baschdello/UniSeb32/UniSeb32.kicad_pcb

## KiCad design UniSeb32.kicad_pcb (2026-03-05)

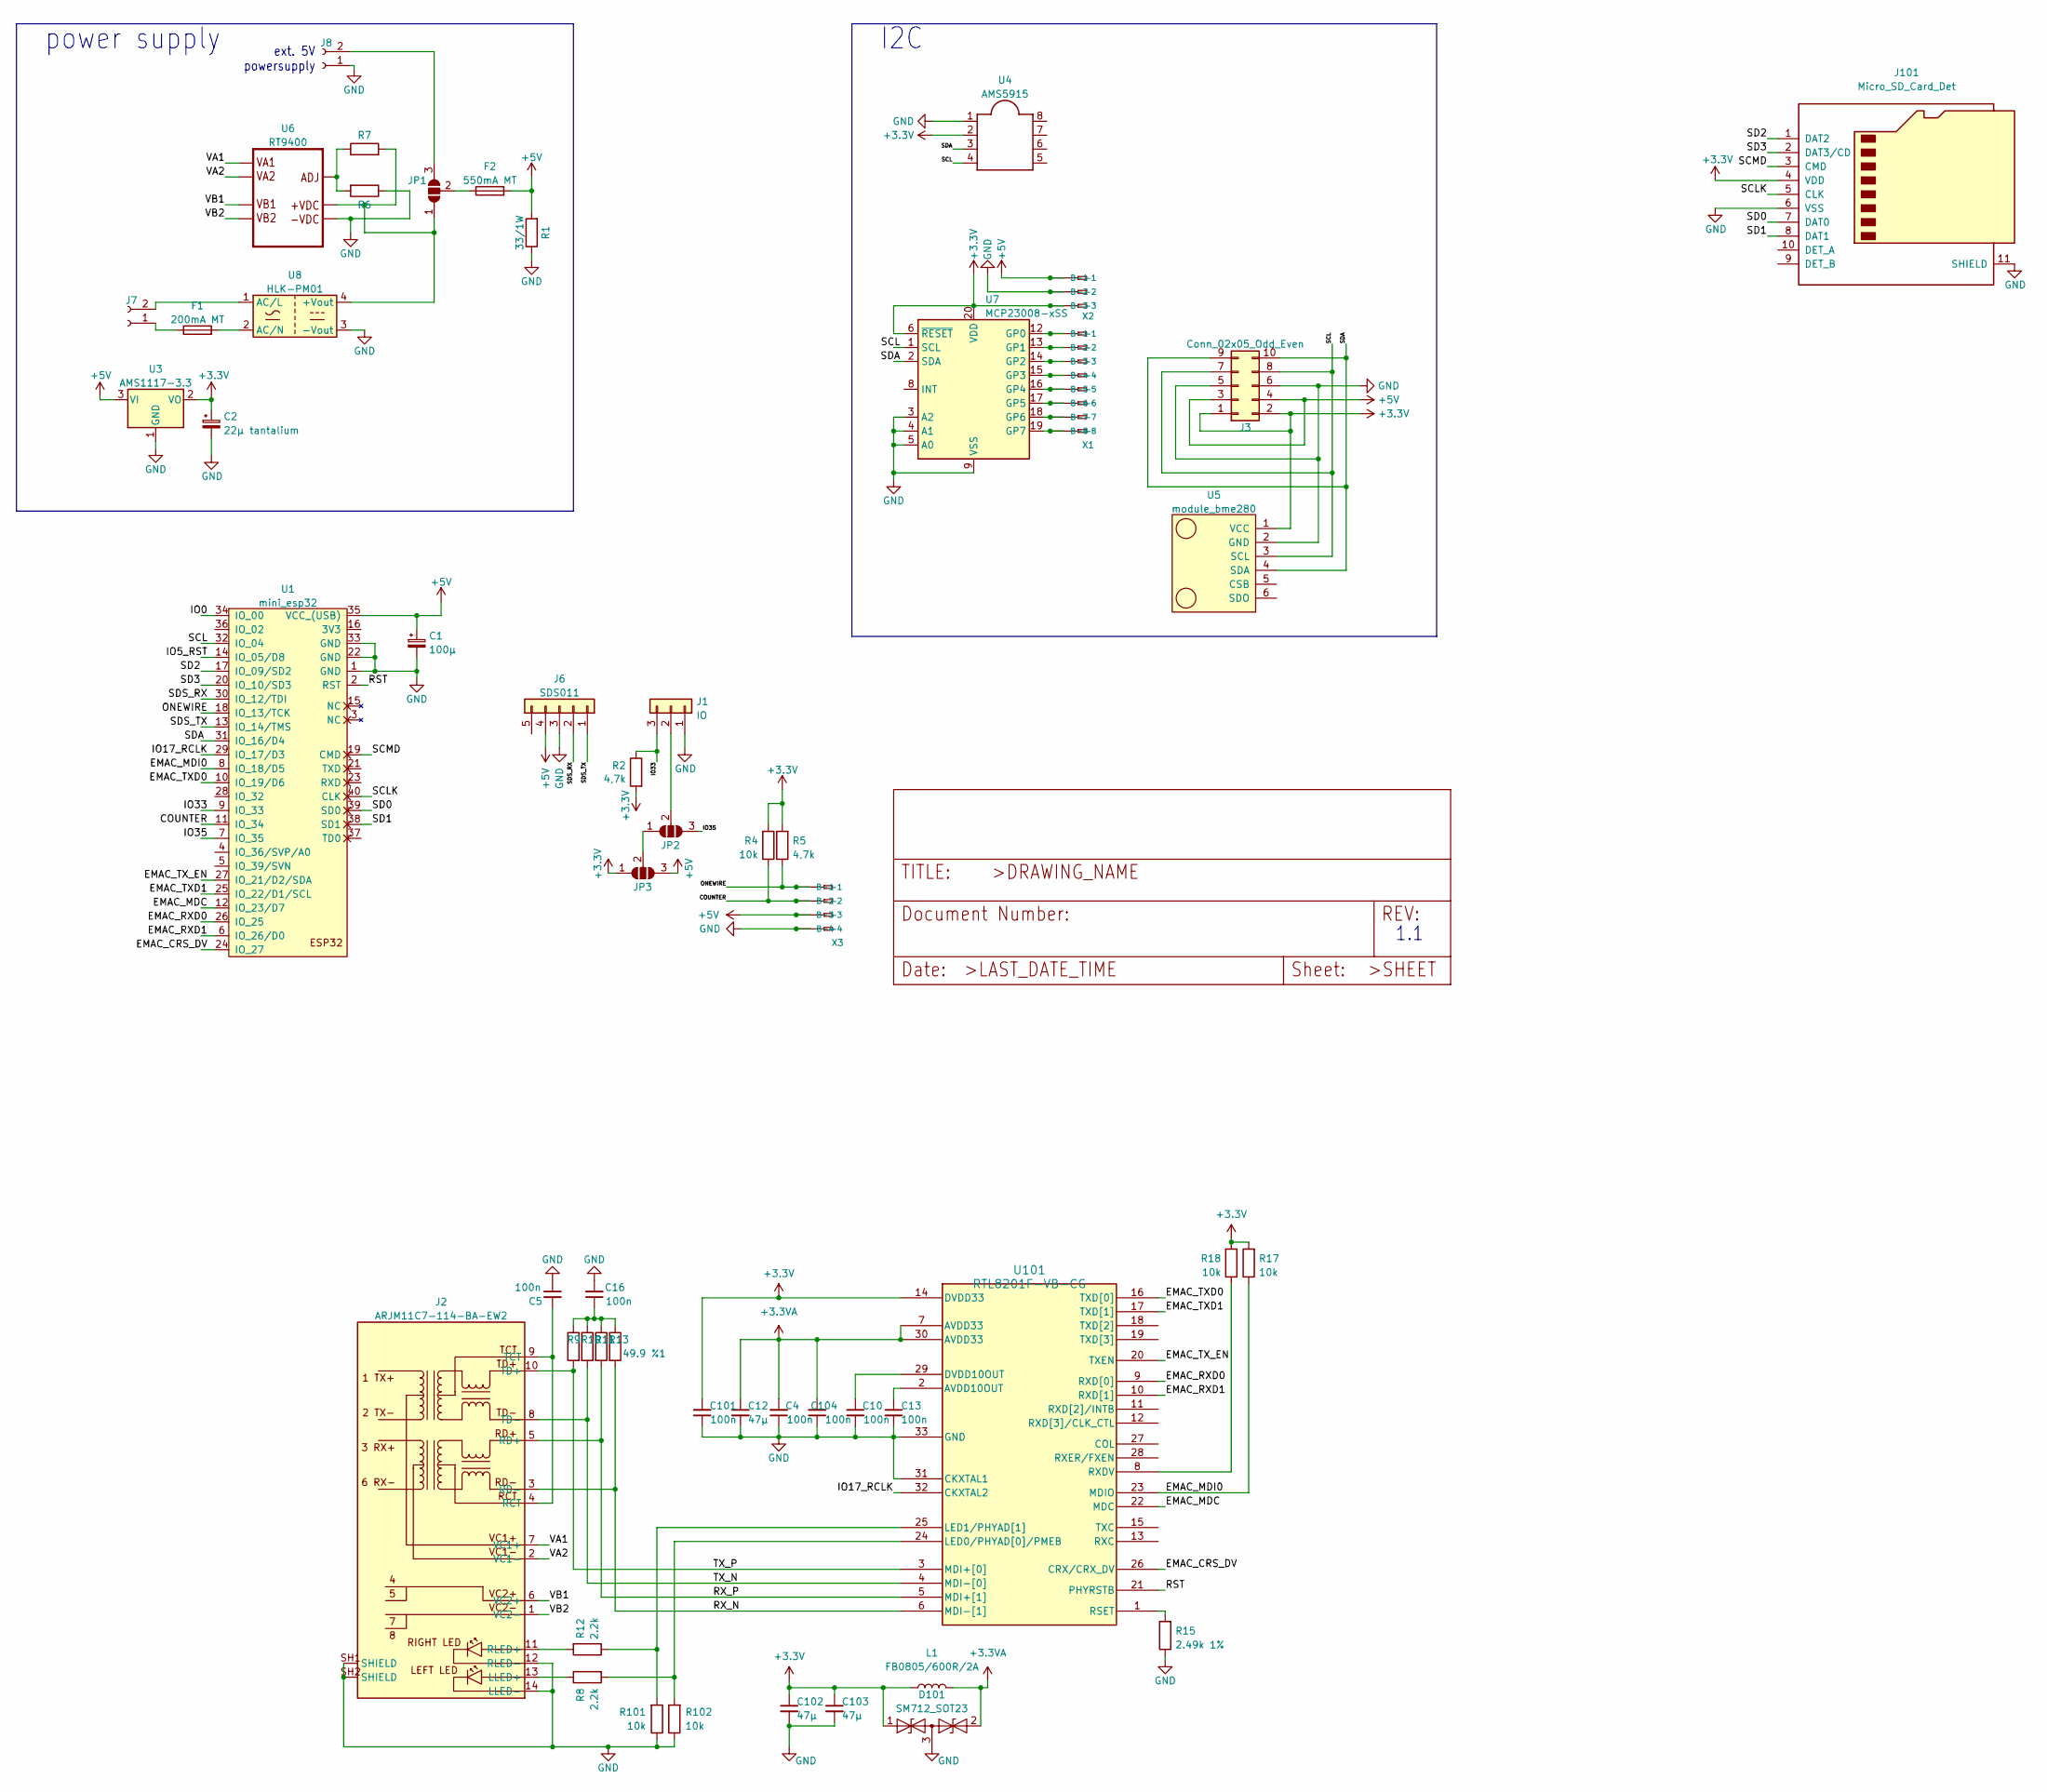
[picture p1: schematic UniSeb32.kicad_sch]

Parts:
C1: 100µ; CP_Radial_D5.0mm_P2.50mm
C2: 22µ tantalium; CP_Radial_D5.0mm_P2.50mm
C4, C5, C10, C13, C16, C101, C104: 100n; C_0603_1608Metric; LCSC C14663
C12, C102, C103: 47µ; C_0805_2012Metric; LCSC C2844386
D101: SM712_SOT23; SOT-23; Digikey 1655-S2303CT-ND
F1: 200mA MT; Fuse_Littelfuse_372_D8.50mm
F2: 550mA MT; Fuse_Littelfuse_372_D8.50mm
J1: IO; FanPinHeader_1x03_P2.54mm_Vertical
J2: ARJM11C7-114-BA-EW2
J3: Conn_02x05_Odd_Even; PinHeader_2x05_P2.54mm_Vertical_SMD
J6: SDS011; JST_XH_B5B-XH-A_1x05_P2.50mm_Vertical
J7, J8: Conn_01x02_Female; TerminalBlock_bornier-2_P5.08mm
J101: Micro_SD_Card_Det; microSD_HC_Hirose_DM3D-SF
JP1, JP2, JP3: SolderJumper_3_Open; SolderJumper-3_P1.3mm_Open_Pad1.0x1.5mm_NumberLabels
L1: FB0805/600R/2A; L_0805_2012Metric; LCSC C1017
R1: 33/1W; R_Axial_DIN0414_L11.9mm_D4.5mm_P5.08mm_Vertical
R2, R5: 4,7k; R_0603_1608Metric; LCSC C23162
R4: 10k; R_0603_1608Metric; JLC 0603
R6, R7: R; R_0603_1608Metric
R8, R12: 2.2k; R_0603_1608Metric; LCSC C4190
R9, R10, R11, R13: 49.9 %1; R_0603_1608Metric; LCSC C23185
R15: 2.49k 1%; R_0603_1608Metric; LCSC C203449
R17, R18, R101, R102: 10k; R_0603_1608Metric; LCSC C25804
U1: mini_esp32; ESP32_mini
U3: AMS1117-3.3; SOT-223-3_TabPin2; LCSC C6186
U4: AMS5915
U5: module_bme280
U6: RT9400
U7: MCP23008-xSS; SSOP-20_5.3x7.2mm_P0.65mm
U8: HLK-PM01; Converter_ACDC_HiLink_HLK-PMxx
U101: RTL8201F-VB-CG; QFN_8201F-VB-CG_RTK; LCSC C45044
X1: 233-508; con-wago-233-508
X2: 233-503; con-wago-233-503
X3: 233-504; con-wago-233-504

Connections:
+3.3V: C2.1, C101.2, C102.1, C103.1, D101.1 (A1), J3.1, J3.2, J101.4 (VDD), JP3.1 (A), L1.1, R2.2, R4.2, R5.2, R17.2, R18.2, U3.2 (VO), U4.2 (VCC), U5.1 (VCC), U7.6 (~RESET), U7.20 (VDD), U101.14 (DVDD33), X2.A3 (-3), X2.B3 (B-3)
+3.3VA: C4.2, C12.1, C104.2, D101.2 (A2), L1.2, U101.7 (AVDD33), U101.30 (AVDD33)
+5V: C1.1, F2.2, J3.3, J3.4, J6.4, JP3.3 (B), R1.2, U1.35 (VCC_(USB)), U3.3 (VI), X2.A1 (-1), X2.B1 (B-1), X3.A3 (-3), X3.B3 (B-3)
/COUNTER: R4.1, U1.11 (IO_34), X3.A2 (-2), X3.B2 (B-2)
/EMAC_CRS_DV: U1.24 (IO_27), U101.26 (CRX/CRX_DV)
/EMAC_MDC: U1.12 (IO_23/D7), U101.22 (MDC)
/EMAC_MDI0: R17.1, U1.8 (IO_18/D5), U101.23 (MDIO)
/EMAC_RXD0: U1.26 (IO_25), U101.9 (RXD[0])
/EMAC_RXD1: U1.6 (IO_26/D0), U101.10 (RXD[1])
/EMAC_TXD0: U1.10 (IO_19/D6), U101.16 (TXD[0])
/EMAC_TXD1: U1.25 (IO_22/D1/SCL), U101.17 (TXD[1])
/EMAC_TX_EN: U1.27 (IO_21/D2/SDA), U101.20 (TXEN)
/IO0: U1.34 (IO_00)
/IO5_RST: U1.14 (IO_05/D8)
/IO17_RCLK: U1.29 (IO_17/D3), U101.32 (CKXTAL2)
/IO33: J1.3, R2.1, U1.9 (IO_33)
/IO35: JP2.3 (B), U1.7 (IO_35)
/ONEWIRE: R5.1, U1.18 (IO_13/TCK), X3.A1 (-1), X3.B1 (B-1)
/RST: U1.2 (RST), U101.21 (PHYRSTB)
/RX_N: J2.3 (RD-), R13.2, U101.6 (MDI-[1])
/RX_P: J2.5 (RD+), R11.2, U101.5 (MDI+[1])
/SCL: J3.7, J3.8, U1.32 (IO_04), U4.4 (SCL), U5.3 (SCL), U7.1 (SCL)
/SCLK: J101.5 (CLK), U1.40 (CLK)
/SCMD: J101.3 (CMD), U1.19 (CMD)
/SD0: J101.7 (DAT0), U1.39 (SD0)
/SD1: J101.8 (DAT1), U1.38 (SD1)
/SD2: J101.1 (DAT2), U1.17 (IO_09/SD2)
/SD3: J101.2 (DAT3/CD), U1.20 (IO_10/SD3)
/SDA: J3.9, J3.10, U1.31 (IO_16/D4), U4.3 (SDA), U5.4 (SDA), U7.2 (SDA)
/SDS_RX: J6.2, U1.30 (IO_12/TDI)
/SDS_TX: J6.1, U1.13 (IO_14/TMS)
/TX_N: J2.8 (TD-), R10.2, U101.4 (MDI-[0])
/TX_P: J2.10 (TD+), R9.2, U101.3 (MDI+[0])
/VA1: J2.7 (VC1+), U6.P$1 (VA1)
/VA2: J2.2 (VC1-), U6.P$2 (VA2)
/VB1: J2.6 (VC2+), U6.P$3 (VB1)
/VB2: J2.1 (VC2-), U6.P$4 (VB2)
GND: C1.2, C2.2, C4.1, C5.1, C10.2, C12.2, C13.2, C16.2, C101.1, C102.2, C103.2, C104.1, D101.3 (common), J1.1, J2.12 (RLED-), J2.14 (LLED-), J2.SH1 (SHIELD), J2.SH2 (SHIELD), J3.5, J3.6, J6.3, J8.1, J101.6 (VSS), J101.11 (SHIELD), R1.1, R6.1, R15.1, R101.1, R102.1, U1.1 (GND), U1.22 (GND), U1.33 (GND), U3.1 (GND), U4.1 (GND), U5.2 (GND), U6.P$5 (-VDC), U7.3 (A2), U7.4 (A1), U7.5 (A0), U7.9 (VSS), U8.3 (-Vout), U101.31 (CKXTAL1), U101.33 (GND), X2.A2 (-2), X2.B2 (B-2), X3.A4 (-4), X3.B4 (B-4)
unnamed: C16.1, R9.1, R10.1, R11.1, R13.1
unnamed: J1.2, JP2.2 (C)
unnamed: J2.13 (LLED+), R8.1
unnamed: C5.2, J2.4 (RCT), J2.9 (TCT)
unnamed: J2.11 (RLED+), R12.2
unnamed: F1.1, J7.1
unnamed: J7.2, U8.1 (AC/L)
unnamed: J8.2, JP1.3 (B)
unnamed: JP1.1 (A), R7.2, U6.P$6 (+VDC), U8.4 (+Vout)
unnamed: F2.1, JP1.2 (C)
unnamed: JP2.1 (A), JP3.2 (C)
unnamed: R6.2, R7.1, U6.P$7 (ADJ)
unnamed: U7.12 (GP0), X1.A1 (-1), X1.B1 (B-1)
unnamed: U7.13 (GP1), X1.A2 (-2), X1.B2 (B-2)
unnamed: U7.14 (GP2), X1.A3 (-3), X1.B3 (B-3)
unnamed: U7.15 (GP3), X1.A4 (-4), X1.B4 (B-4)
unnamed: U7.16 (GP4), X1.A5 (-5), X1.B5 (B-5)
unnamed: U7.17 (GP5), X1.A6 (-6), X1.B6 (B-6)
unnamed: U7.18 (GP6), X1.A7 (-7), X1.B7 (B-7)
unnamed: U7.19 (GP7), X1.A8 (-8), X1.B8 (B-8)
unnamed: F1.2, U8.2 (AC/N)
unnamed: C13.1, U101.2 (AVDD10OUT)
unnamed: C10.1, U101.29 (DVDD10OUT)
unnamed: R8.2, R102.2, U101.24 (LED0/PHYAD[0]/PMEB)
unnamed: R12.1, R101.2, U101.25 (LED1/PHYAD[1])
unnamed: R15.2, U101.1 (RSET)
unnamed: R18.1, U101.8 (RXDV)

Notes on the sheet:
I2C
1.1
power supply
ext. 5V powersupply

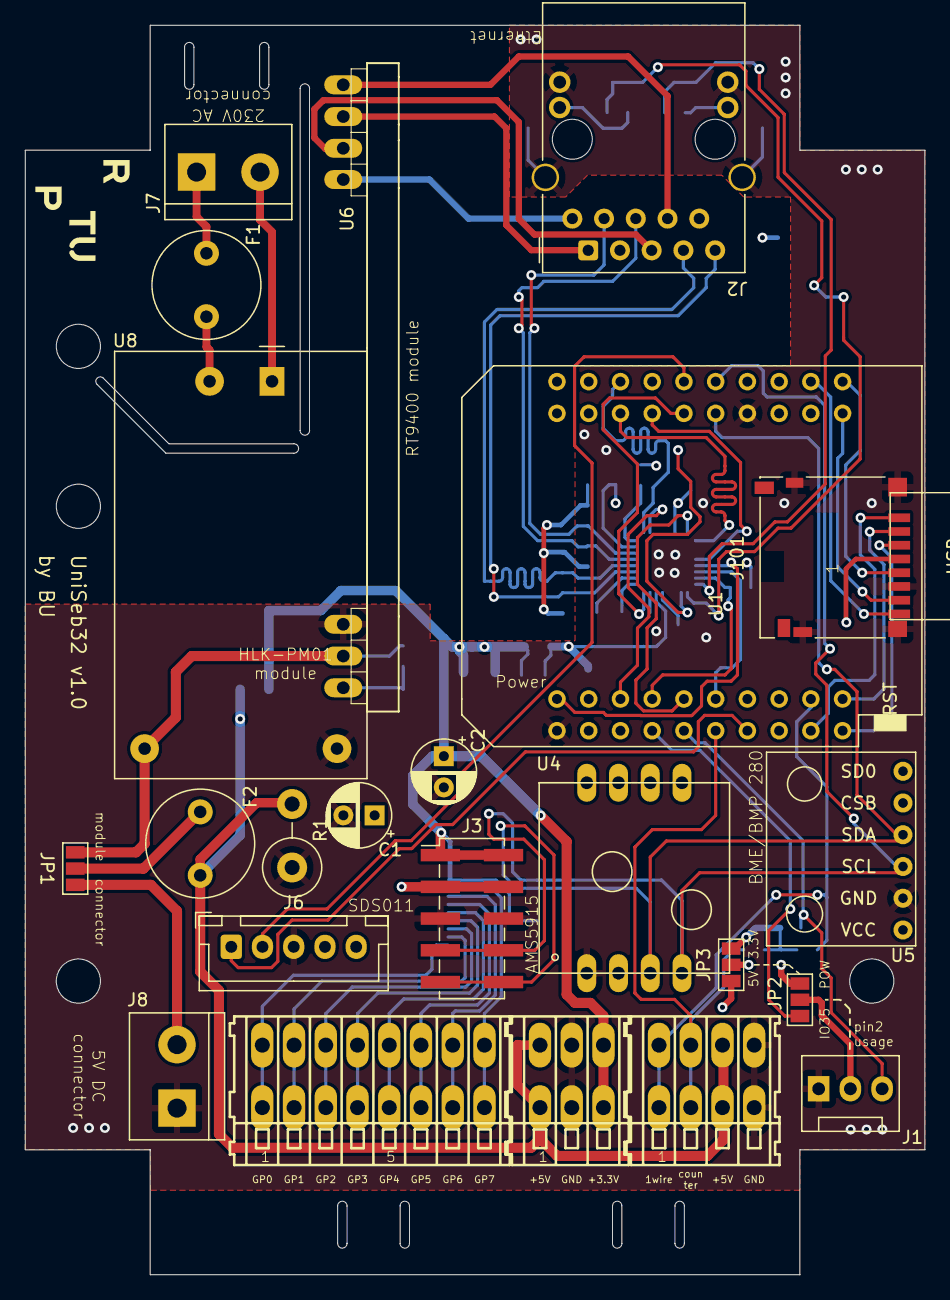
[picture p2: board UniSeb32.kicad_pcb from above]

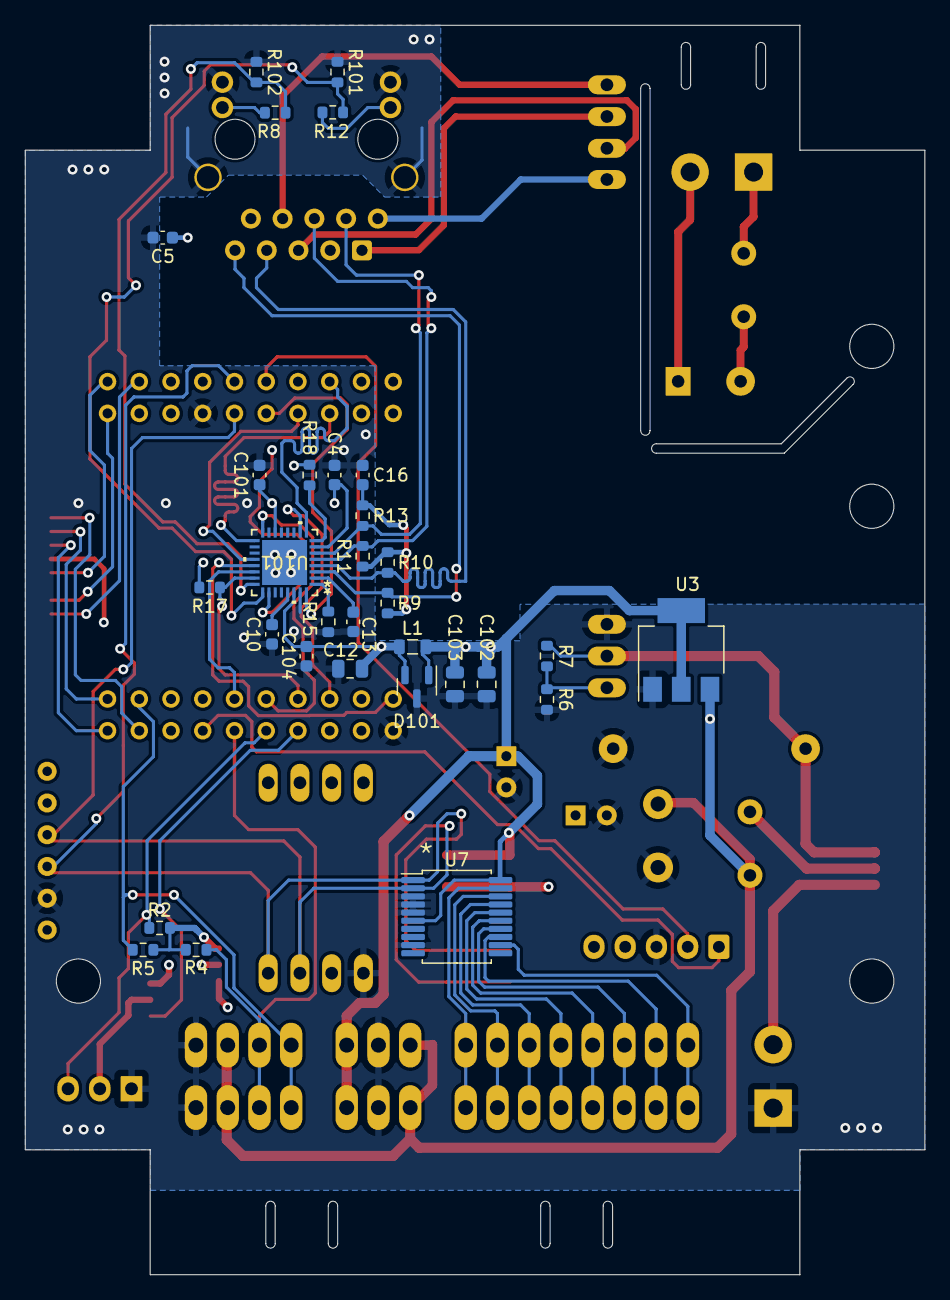
[picture p3: board UniSeb32.kicad_pcb from below]

Board: 4 copper layers, 72.0 x 100.0 mm, 54 parts (31 on the bottom side), 63 nets.
