baschdello/UniSeb32/(commit log)

2023-05-15 switched to 4 layer PCB. Routed remaining airwires
    [UniSeb32.kicad_pcb, UniSeb32.kicad_sch]
2023-08-10 Added attributes for jlcpcb assembly
    [UniSeb32-B_Cu.gbl, UniSeb32-B_Mask.gbs, UniSeb32-B_Paste.gbp, UniSeb32-B_Silkscreen.gbo, UniSeb32-Edge_Cuts.gm1, UniSeb32-F_Cu.gtl, UniSeb32-F_Mask.gts, UniSeb32-F_Paste.gtp]
2023-09-05 Fixes wrong pin numbering at Y1
    [UniSeb32.kicad_pcb, UniSeb32.kicad_sch]
2023-09-12 corrected mapping of pins added SD slot removed crystal y1 and capacitors in bom and cpl file
    [UniSeb32.kicad_pcb, UniSeb32.kicad_sch, UniSeb32_bom_bot.csv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]
2024-02-21 Changed PHY to RTL8201F
    [UniSeb32.kicad_sch]
2024-03-04 finished routing
    [UniSeb32.kicad_pcb]
2024-06-06 removed SJ1, rename SJ2 -> SJ1, added SJ2 to change pin2 usage of J1
    [UniSeb32.kicad_pcb, UniSeb32.kicad_sch, UniSeb32_bom_bot.csv, UniSeb32_bom_top.csv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]
2024-06-06 added pullup for pin3 of J1
    [UniSeb32.kicad_pcb, UniSeb32.kicad_sch]
2024-06-24 Changed JP2-fixed voltage option (3.3V) to flexible voltage (3.3V/5V) with JP3
    [UniSeb32.kicad_pcb, UniSeb32.kicad_sch]
2024-08-01 changed via type near C101
    [UniSeb32.kicad_pcb]
2026-03-05 ESP32 und Power-Module verschoben wegen Gehäuseabmessungen
    [UniSeb32.kicad_pcb]
